drunkbatya/DrunkPCDebugger/README.md

# DrunkPC Debugger
A debugger and flasher for [DrunkPC](https://github.com/drunkbatya/DrunkPC)

<picture>
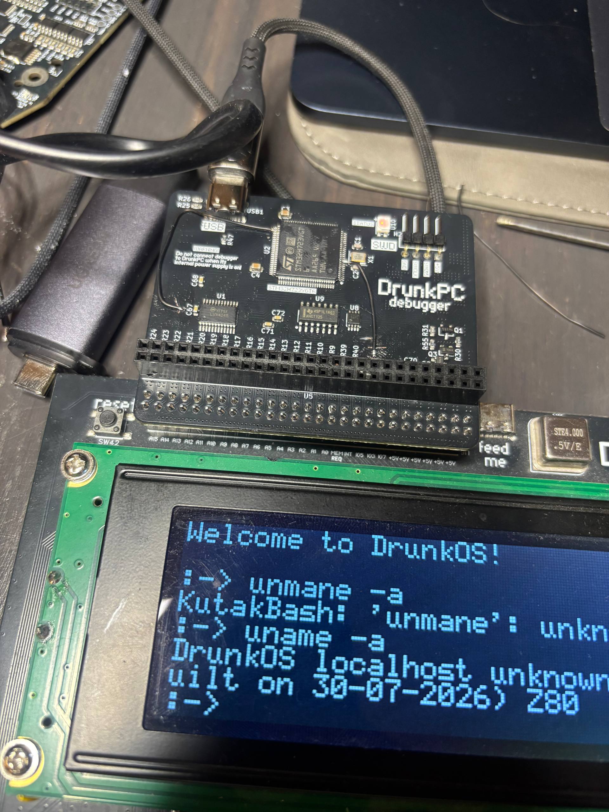
[picture p1: .github/assets/drunkpc_debugger_in_work.jpg]
    
</picture>

## How to use

## How to build firmware

## How to cli tool
