drunkbatya/DrunkPCDebugger/hardware/kicad/production/zip/bom.csv

Designator | Footprint | Quantity | Value | LCSC Part #
3V3_1 | TestPoint_Pad_D1.5mm | 1 | 3v3
5V_1 | TestPoint_Pad_D1.5mm | 1 | 5v
5V_BUS_1 | TestPoint_Pad_D1.5mm | 1 | 5vBus
C1, C2 | 0603 | 2 | CL10C180JB8NNNC | C1647
C3 | CP_EIA-3528-21_Kemet-B | 1 | 100uF 6.3V | C16133
C38 | EEFCX0J101R | 1 | EEFCX0J101R | C189619
C4 | 0805 | 1 | 10uF 25V | C15850
C43 | 0603 | 1 | CL10A475KO8NNNC | C19666
C5, C6 | 0603 | 2 | 2.2uF 16V | C23630
C59, C60, C61, C62, C63, C64, C65, C66, C67, C68, C69, C70, C71, C72, C73, C74, C75, C76 | 0603 | 18 | CC0603KRX7R9BB104 | C14663
C7 | 0603 | 1 | 2.2uF | C23630
D1 | USBLC6-2SC6_C2687116 | 1 | USBLC6-2SC6_C2687116 | C2687116
GND1 | TestPoint_Pad_2.0x2.0mm | 1 | GND
H1 | X6521WV-2_27H-C30D60 | 1 | X6521WV-2_27H-C30D60 | C725899
H2 | PZ254R-11-05P | 1 | PZ254R-11-05P | C492413
Q1, Q4 | AO3400A | 2 | AO3400A | C20917
Q2, Q3 | AO3401A | 2 | AO3401A | C15127
R1, R10, R11, R12, R13, R14, R15, R16, R17, R18, R19, R2, R20, R21, R22, R23, R24, R3, R36, R37, R38, R39, R4, R40, R41, R44, R5, R6, R7, R8, R9 | 0603 | 31 | 0603WAF1000T5E | C22775
R25, R26 | 0603 | 2 | 0603WAF5101T5E | C23186
R27, R28, R31, R32 | 0603 | 4 | 0603WAF1001T5E | C21190
R29, R30, R45, R46 | 0603 | 4 | 10kΩ | C25804
R33 | 0603 | 1 | 0603WAF1003T5E | C25803
R34, R35 | 0603 | 2 | 47kΩ | C25819
R42, R43, R47, R48, R49, R52, R53, R54, R55, R56, R57, R58 | 0603 | 12 | 0603WAF1002T5E | C25804
SW2, SW3 | TS3643TP | 2 | TS3643TP | C398054
U1, U3, U4, U7 | SN74LVC4245APWR | 4 | SN74LVC4245APWR | C7859
U10 | A-SC6302R6AGHC-A03-2T | 1 | A-SC6302R6AGHC-A03-2T | C5355456
U11 | SN74LVC3G07DCTR | 1 | SN74LVC3G07DCTR | C131914
U2 | STM32H723VET6 | 1 | STM32H723VET6 | C730141
U5 | X6521FV-2X27-C85D32 | 1 | X6521FV-2X27-C85D32 | C2884000
U6 | AMS1117-3_3 | 1 | AMS1117-3_3 | C6186
U8 | SN74LVC3G17DCTR | 1 | SN74LVC3G17DCTR | C18213
USB1 | TYPE-C_16PIN_2MD_073 | 1 | TYPE-C_16PIN_2MD_073 | C2765186
X1 | Crystal_SMD_3225-4Pin_3.2x2.5mm | 1 | X322525MOB4SI | C9006
