drunkbatya/DrunkPCDebugger/hardware/kicad/DrunkPCDebugger.kicad_pcb

## KiCad design hardware/kicad/DrunkPCDebugger.kicad_pcb (2026-10-22)

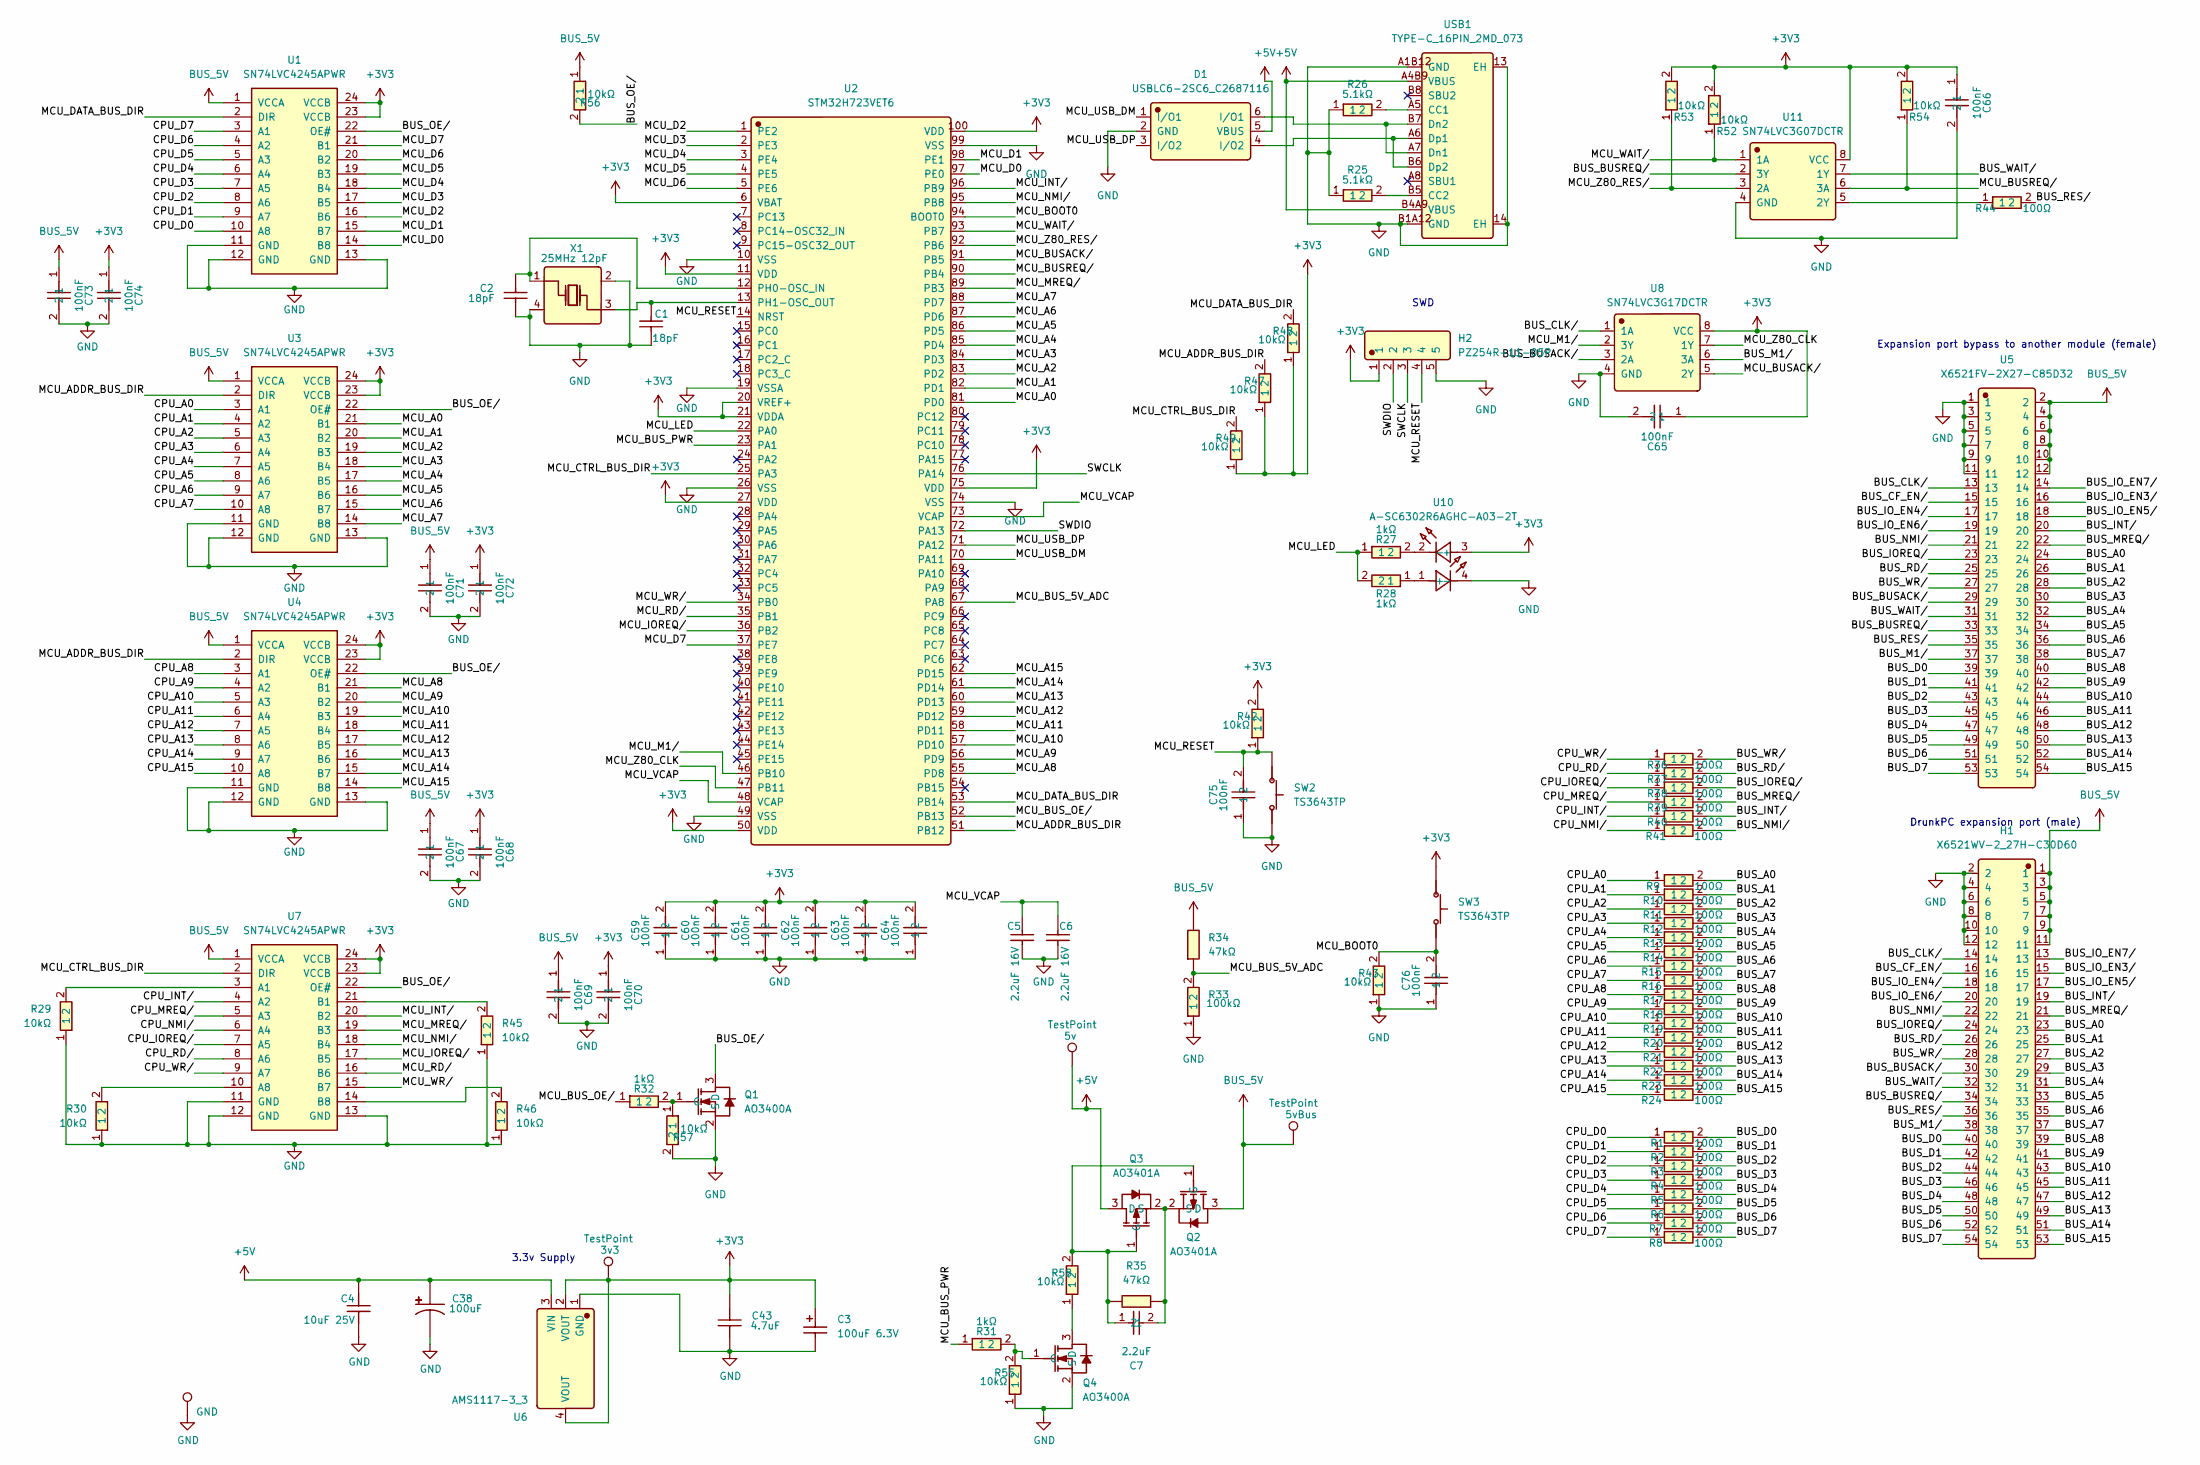
[picture p2: schematic DrunkPCDebugger.kicad_sch]

Parts:
3v3_1: 3v3; TestPoint_Pad_D1.5mm
5v_1: 5v; TestPoint_Pad_D1.5mm
5v_bus_1: 5vBus; TestPoint_Pad_D1.5mm
C1, C2: CL10C180JB8NNNC; C_0603_1608Metric; Manufacturer Part CL10C180JB8NNNC; LCSC C1647
C3: 100uF 6.3V; CP_EIA-3528-21_Kemet-B; Manufacturer Part TAJB107K006RNJ; LCSC C16133
C4: 10uF 25V; C_0805_2012Metric; Manufacturer Part CL21A106KAYNNNE; LCSC C15850
C5, C6: 2.2uF 16V; C_0603_1608Metric; Manufacturer Part CL10A225KO8NNNC; LCSC C23630
C7: 2.2uF; C_0603_1608Metric; Manufacturer Part CL10A225KO8NNNC; LCSC C23630
C38: EEFCX0J101R; Manufacturer Part EEFCX0J101R; LCSC C189619
C43: CL10A475KO8NNNC; C_0603_1608Metric; Manufacturer Part CL10A475KO8NNNC; LCSC C19666
C59, C60, C61, C62, C63, C64, C65, C66, C67, C68, C69, C70, C71, C72, C73, C74, C75, C76: CC0603KRX7R9BB104; C_0603_1608Metric; Manufacturer Part CC0603KRX7R9BB104; LCSC C14663
D1: USBLC6-2SC6_C2687116; Manufacturer Part USBLC6-2SC6; LCSC C2687116
GND1: GND; TestPoint_Pad_2.0x2.0mm
H1: X6521WV-2_27H-C30D60; Manufacturer Part X6521WV-2x27H-C60D30; LCSC C725899
H2: PZ254R-11-05P; Manufacturer Part PZ254R-11-05P; LCSC C492413
Q1, Q4: AO3400A; Manufacturer Part AO3400A; LCSC C20917
Q2, Q3: AO3401A; Manufacturer Part AO3401A; LCSC C15127
R1, R2, R3, R4, R5, R6, R7, R8, R9, R10, R11, R12, R13, R14, R15, R16, R17, R18, R19, R20, R21, R22, R23, R24, R36, R37, R38, R39, R40, R41, R44: 0603WAF1000T5E; R_0603_1608Metric; Manufacturer Part 0603WAF1000T5E; LCSC C22775
R25, R26: 0603WAF5101T5E; R_0603_1608Metric; Manufacturer Part 0603WAF5101T5E; LCSC C23186
R27, R28, R31, R32: 0603WAF1001T5E; R_0603_1608Metric; Manufacturer Part 0603WAF1001T5E; LCSC C21190
R29, R30, R45, R46: 10kΩ; R_0603_1608Metric; Manufacturer Part 0603WAF1002T5E; LCSC C25804
R33: 0603WAF1003T5E; R_0603_1608Metric; Manufacturer Part 0603WAF1003T5E; LCSC C25803
R34, R35: 47kΩ; R_0603_1608Metric; Manufacturer Part 0603WAF4702T5E; LCSC C25819
R42, R43, R47, R48, R49, R52, R53, R54, R55, R56, R57, R58: 0603WAF1002T5E; R_0603_1608Metric; Manufacturer Part 0603WAF1002T5E; LCSC C25804
SW2, SW3: TS3643TP; Manufacturer Part TS3643TP; LCSC C398054
U1, U3, U4, U7: SN74LVC4245APWR; Manufacturer Part SN74LVC4245APWR; LCSC C7859
U2: STM32H723VET6; Manufacturer Part STM32H723VET6; LCSC C730141
U5: X6521FV-2X27-C85D32; Manufacturer Part X6521FV-2x27-C85D32; LCSC C2884000
U6: AMS1117-3_3; Manufacturer Part AMS1117-3.3; LCSC C6186
U8: SN74LVC3G17DCTR; Manufacturer Part SN74LVC3G17DCTR; LCSC C18213
U10: A-SC6302R6AGHC-A03-2T; Manufacturer Part A-SC6302R6AGHC-A03-2T; LCSC C5355456
U11: SN74LVC3G07DCTR; Manufacturer Part SN74LVC3G07DCTR; LCSC C131914
USB1: TYPE-C_16PIN_2MD_073; Manufacturer Part TYPE-C 16PIN 2MD(073); LCSC C2765186
X1: X322525MOB4SI; Crystal_SMD_3225-4Pin_3.2x2.5mm; Manufacturer Part X322525MOB4SI; LCSC C9006

Connections:
+3V3: 3v3_1.1 (1_1), C3.1, C43.2, C59.2, C60.2, C61.2, C62.2, C63.2, C64.2, C65.1, C66.1, C68.1, C70.1, C72.1, C74.1, H2.1, R42.2, R47.1, R48.1, R49.1, R52.2, R53.2, R54.2, SW3.1, U1.23 (VCCB), U1.24 (VCCB), U2.6 (VBAT), U2.11 (VDD), U2.20 (VREF+), U2.21 (VDDA), U2.27 (VDD), U2.50 (VDD), U2.75 (VDD), U2.100 (VDD), U3.23 (VCCB), U3.24 (VCCB), U4.23 (VCCB), U4.24 (VCCB), U6.2 (VOUT), U6.4 (VOUT), U7.23 (VCCB), U7.24 (VCCB), U8.8 (VCC), U10.3 (+), U11.8 (VCC)
+5V: 5v_1.1 (1_1), C4.1, C38.1, D1.5 (VBUS), Q3.3 (D), U6.3 (VIN), USB1.A4B9 (VBUS), USB1.B4A9 (VBUS)
/BUS_A0: H1.23, R9.2, U5.24
/BUS_A1: H1.25, R10.2, U5.26
/BUS_A2: H1.27, R11.2, U5.28
/BUS_A3: H1.29, R12.2, U5.30
/BUS_A4: H1.31, R13.2, U5.32
/BUS_A5: H1.33, R14.2, U5.34
/BUS_A6: H1.35, R15.2, U5.36
/BUS_A7: H1.37, R16.2, U5.38
/BUS_A8: H1.39, R17.2, U5.40
/BUS_A9: H1.41, R18.2, U5.42
/BUS_A10: H1.43, R19.2, U5.44
/BUS_A11: H1.45, R20.2, U5.46
/BUS_A12: H1.47, R21.2, U5.48
/BUS_A13: H1.49, R22.2, U5.50
/BUS_A14: H1.51, R23.2, U5.52
/BUS_A15: H1.53, R24.2, U5.54
/BUS_BUSACK/: H1.30, U5.29, U8.3 (2A)
/BUS_BUSREQ/: H1.34, U5.33, U11.2 (3Y)
/BUS_CF_EN/: H1.16, U5.15
/BUS_CLK/: H1.14, U5.13, U8.1 (1A)
/BUS_D0: H1.40, R1.2, U5.39
/BUS_D1: H1.42, R2.2, U5.41
/BUS_D2: H1.44, R3.2, U5.43
/BUS_D3: H1.46, R4.2, U5.45
/BUS_D4: H1.48, R5.2, U5.47
/BUS_D5: H1.50, R6.2, U5.49
/BUS_D6: H1.52, R7.2, U5.51
/BUS_D7: H1.54, R8.2, U5.53
/BUS_INT/: H1.19, R40.2, U5.20
/BUS_IOREQ/: H1.24, R38.2, U5.23
/BUS_IO_EN3/: H1.15, U5.16
/BUS_IO_EN4/: H1.18, U5.17
/BUS_IO_EN5/: H1.17, U5.18
/BUS_IO_EN6/: H1.20, U5.19
/BUS_IO_EN7/: H1.13, U5.14
/BUS_M1/: H1.38, U5.37, U8.6 (3A)
/BUS_MREQ/: H1.21, R39.2, U5.22
/BUS_NMI/: H1.22, R41.2, U5.21
/BUS_OE/: Q1.3 (D), R56.2, U1.22 (OE#), U3.22 (OE#), U4.22 (OE#), U7.22 (OE#)
/BUS_RD/: H1.26, R37.2, U5.25
/BUS_RES/: H1.36, R44.2, U5.35
/BUS_WAIT/: H1.32, U5.31, U11.7 (1Y)
/BUS_WR/: H1.28, R36.2, U5.27
/CPU_A0: R9.1, U3.3 (A1)
/CPU_A1: R10.1, U3.4 (A2)
/CPU_A2: R11.1, U3.5 (A3)
/CPU_A3: R12.1, U3.6 (A4)
/CPU_A4: R13.1, U3.7 (A5)
/CPU_A5: R14.1, U3.8 (A6)
/CPU_A6: R15.1, U3.9 (A7)
/CPU_A7: R16.1, U3.10 (A8)
/CPU_A8: R17.1, U4.3 (A1)
/CPU_A9: R18.1, U4.4 (A2)
/CPU_A10: R19.1, U4.5 (A3)
/CPU_A11: R20.1, U4.6 (A4)
/CPU_A12: R21.1, U4.7 (A5)
/CPU_A13: R22.1, U4.8 (A6)
/CPU_A14: R23.1, U4.9 (A7)
/CPU_A15: R24.1, U4.10 (A8)
/CPU_D0: R1.1, U1.10 (A8)
/CPU_D1: R2.1, U1.9 (A7)
/CPU_D2: R3.1, U1.8 (A6)
/CPU_D3: R4.1, U1.7 (A5)
/CPU_D4: R5.1, U1.6 (A4)
/CPU_D5: R6.1, U1.5 (A3)
/CPU_D6: R7.1, U1.4 (A2)
/CPU_D7: R8.1, U1.3 (A1)
/CPU_INT/: R40.1, U7.4 (A2)
/CPU_IOREQ/: R38.1, U7.7 (A5)
/CPU_MREQ/: R39.1, U7.5 (A3)
/CPU_NMI/: R41.1, U7.6 (A4)
/CPU_RD/: R37.1, U7.8 (A6)
/CPU_WR/: R36.1, U7.9 (A7)
/MCU_A0: U2.81 (PD0), U3.21 (B1)
/MCU_A1: U2.82 (PD1), U3.20 (B2)
/MCU_A2: U2.83 (PD2), U3.19 (B3)
/MCU_A3: U2.84 (PD3), U3.18 (B4)
/MCU_A4: U2.85 (PD4), U3.17 (B5)
/MCU_A5: U2.86 (PD5), U3.16 (B6)
/MCU_A6: U2.87 (PD6), U3.15 (B7)
/MCU_A7: U2.88 (PD7), U3.14 (B8)
/MCU_A8: U2.55 (PD8), U4.21 (B1)
/MCU_A9: U2.56 (PD9), U4.20 (B2)
/MCU_A10: U2.57 (PD10), U4.19 (B3)
/MCU_A11: U2.58 (PD11), U4.18 (B4)
/MCU_A12: U2.59 (PD12), U4.17 (B5)
/MCU_A13: U2.60 (PD13), U4.16 (B6)
/MCU_A14: U2.61 (PD14), U4.15 (B7)
/MCU_A15: U2.62 (PD15), U4.14 (B8)
/MCU_ADDR_BUS_DIR: R47.2, U2.51 (PB12), U3.2 (DIR), U4.2 (DIR)
/MCU_BOOT0: C76.2, R43.2, SW3.2, U2.94 (BOOT0)
/MCU_BUSACK/: U2.91 (PB5), U8.5 (2Y)
/MCU_BUSREQ/: R54.1, U2.90 (PB4), U11.6 (3A)
/MCU_BUS_5V_ADC: R33.2, R34.1, U2.67 (PA8)
/MCU_BUS_OE/: R32.1, U2.52 (PB13)
/MCU_BUS_PWR: R31.1, U2.23 (PA1)
/MCU_CTRL_BUS_DIR: R49.2, U2.25 (PA3), U7.2 (DIR)
/MCU_D0: U1.14 (B8), U2.97 (PE0)
/MCU_D1: U1.15 (B7), U2.98 (PE1)
/MCU_D2: U1.16 (B6), U2.1 (PE2)
/MCU_D3: U1.17 (B5), U2.2 (PE3)
/MCU_D4: U1.18 (B4), U2.3 (PE4)
/MCU_D5: U1.19 (B3), U2.4 (PE5)
/MCU_D6: U1.20 (B2), U2.5 (PE6)
/MCU_D7: U1.21 (B1), U2.37 (PE7)
/MCU_DATA_BUS_DIR: R48.2, U1.2 (DIR), U2.53 (PB14)
/MCU_INT/: U2.96 (PB9), U7.20 (B2)
/MCU_IOREQ/: U2.36 (PB2), U7.17 (B5)
/MCU_LED: R27.1, R28.2, U2.22 (PA0)
/MCU_M1/: U2.46 (PB10), U8.2 (3Y)
/MCU_MREQ/: U2.89 (PB3), U7.19 (B3)
/MCU_NMI/: U2.95 (PB8), U7.18 (B4)
/MCU_RD/: U2.35 (PB1), U7.16 (B6)
/MCU_RESET: C75.2, H2.4, R42.1, SW2.1, U2.14 (NRST)
/MCU_USB_DM: D1.1 (I/O1), U2.70 (PA11)
/MCU_USB_DP: D1.3 (I/O2), U2.71 (PA12)
/MCU_VCAP: C5.1, C6.1, U2.48 (VCAP), U2.73 (VCAP)
/MCU_WAIT/: R52.1, U2.93 (PB7), U11.1 (1A)
/MCU_WR/: U2.34 (PB0), U7.15 (B7)
/MCU_Z80_CLK: U2.47 (PB11), U8.7 (1Y)
/MCU_Z80_RES/: R53.1, U2.92 (PB6), U11.3 (2A)
/SWCLK: H2.3, U2.76 (PA14)
/SWDIO: H2.2, U2.72 (PA13)
BUS_5V: 5v_bus_1.1 (1_1), C67.1, C69.1, C71.1, C73.1, H1.1, H1.3, H1.5, H1.7, H1.9, H1.11, Q2.3 (D), R34.2, R56.1, U1.1 (VCCA), U3.1 (VCCA), U4.1 (VCCA), U5.2, U5.4, U5.6, U5.8, U5.10, U5.12, U7.1 (VCCA)
GND: C1.2, C2.2, C3.2, C4.2, C5.2, C6.2, C38.2, C43.1, C59.1, C60.1, C61.1, C62.1, C63.1, C64.1, C65.2, C66.2, C67.2, C68.2, C69.2, C70.2, C71.2, C72.2, C73.2, C74.2, C75.1, C76.1, D1.2 (GND), GND1.1 (1_1), H1.2, H1.4, H1.6, H1.8, H1.10, H1.12, H2.5, Q1.2 (S), Q4.2 (S), R25.1, R26.1, R29.1, R30.1, R33.1, R43.1, R45.1, R46.1, R55.1, R57.2, SW2.2, U1.11 (GND), U1.12 (GND), U1.13 (GND), U2.10 (VSS), U2.19 (VSSA), U2.26 (VSS), U2.49 (VSS), U2.74 (VSS), U2.99 (VSS), U3.11 (GND), U3.12 (GND), U3.13 (GND), U4.11 (GND), U4.12 (GND), U4.13 (GND), U5.1, U5.3, U5.5, U5.7, U5.9, U5.11, U6.1 (GND), U7.11 (GND), U7.12 (GND), U7.13 (GND), U8.4 (GND), U10.4 (-), U11.4 (GND), USB1.13 (EH), USB1.14 (EH), USB1.A1B12 (GND), USB1.B1A12 (GND), X1.2 (GND), X1.4 (GND)
unnamed: Q1.1 (G), R32.2, R57.1
unnamed: C7.1, Q2.1 (G), Q3.1 (G), R35.2, R58.2
unnamed: C7.2, Q2.2 (S), Q3.2 (S), R35.1
unnamed: Q4.3 (D), R58.1
unnamed: Q4.1 (G), R31.2, R55.2
unnamed: R27.2, U10.2 (-)
unnamed: R28.1, U10.1 (+)
unnamed: C2.1, U2.12 (PH0-OSC_IN), X1.1 (OSC1)
unnamed: C1.1, U2.13 (PH1-OSC_OUT), X1.3 (OSC2)
unnamed: R29.2, U7.3 (A1)
unnamed: R30.2, U7.10 (A8)
unnamed: R45.2, U7.21 (B1)
unnamed: R46.2, U7.14 (B8)
unnamed: R44.1, U11.5 (2Y)
unnamed: R26.2, USB1.A5 (CC1)
unnamed: R25.2, USB1.B5 (CC2)
unnamed: D1.6 (I/O1), USB1.A7 (Dn1), USB1.B7 (Dn2)
unnamed: D1.4 (I/O2), USB1.A6 (Dp1), USB1.B6 (Dp2)

Notes on the sheet:
SWD
DrunkPC expansion port (male)
3.3v Supply
Expansion port bypass to another module (female)

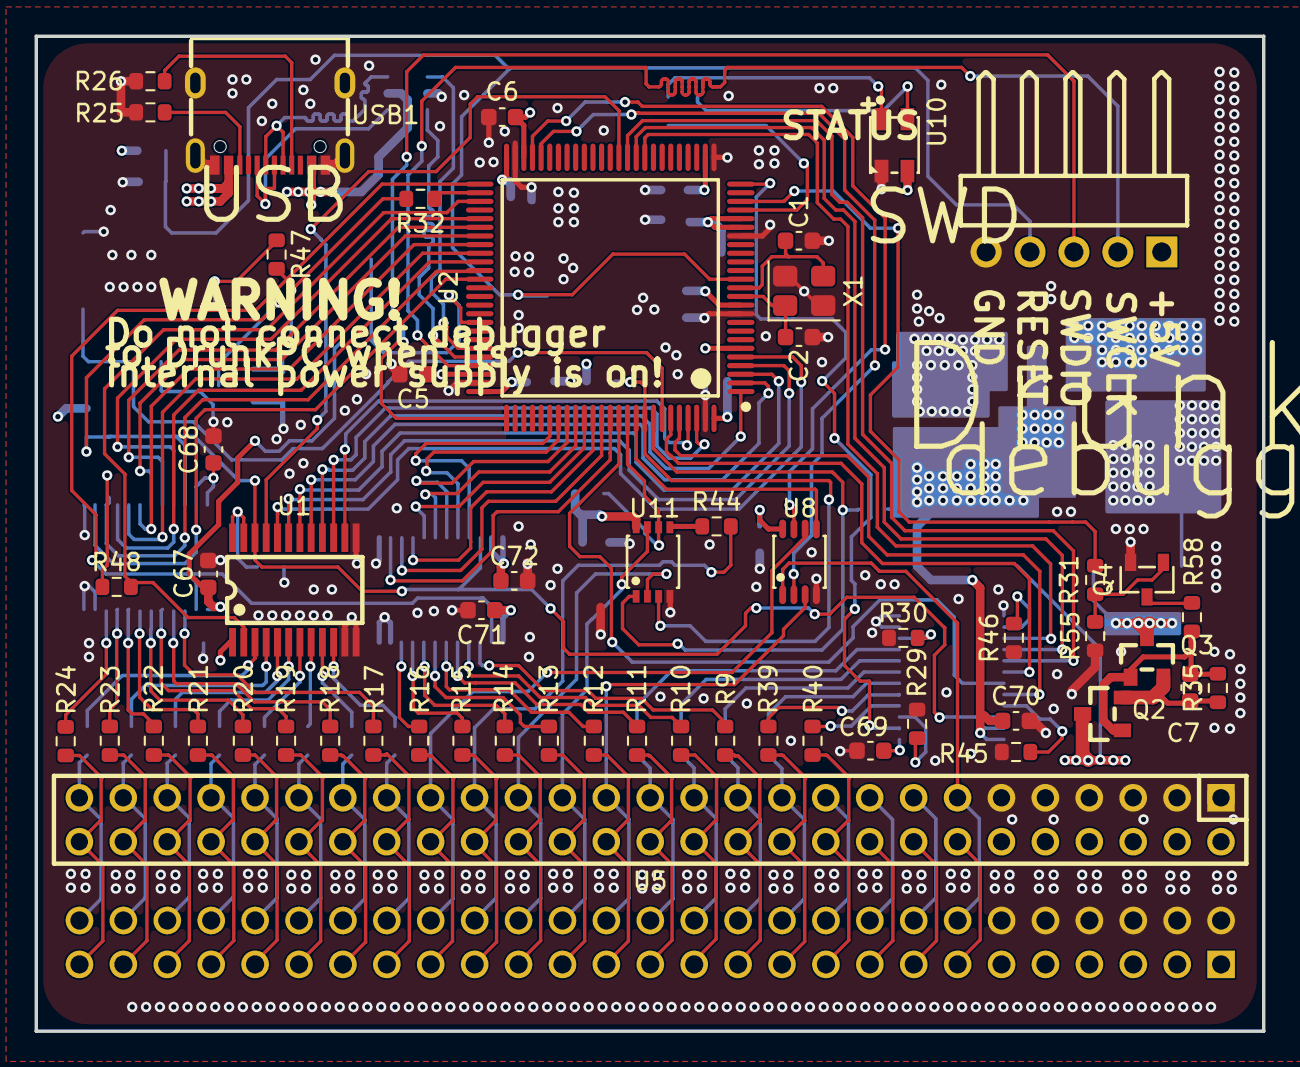
[picture p3: board DrunkPCDebugger.kicad_pcb from above]

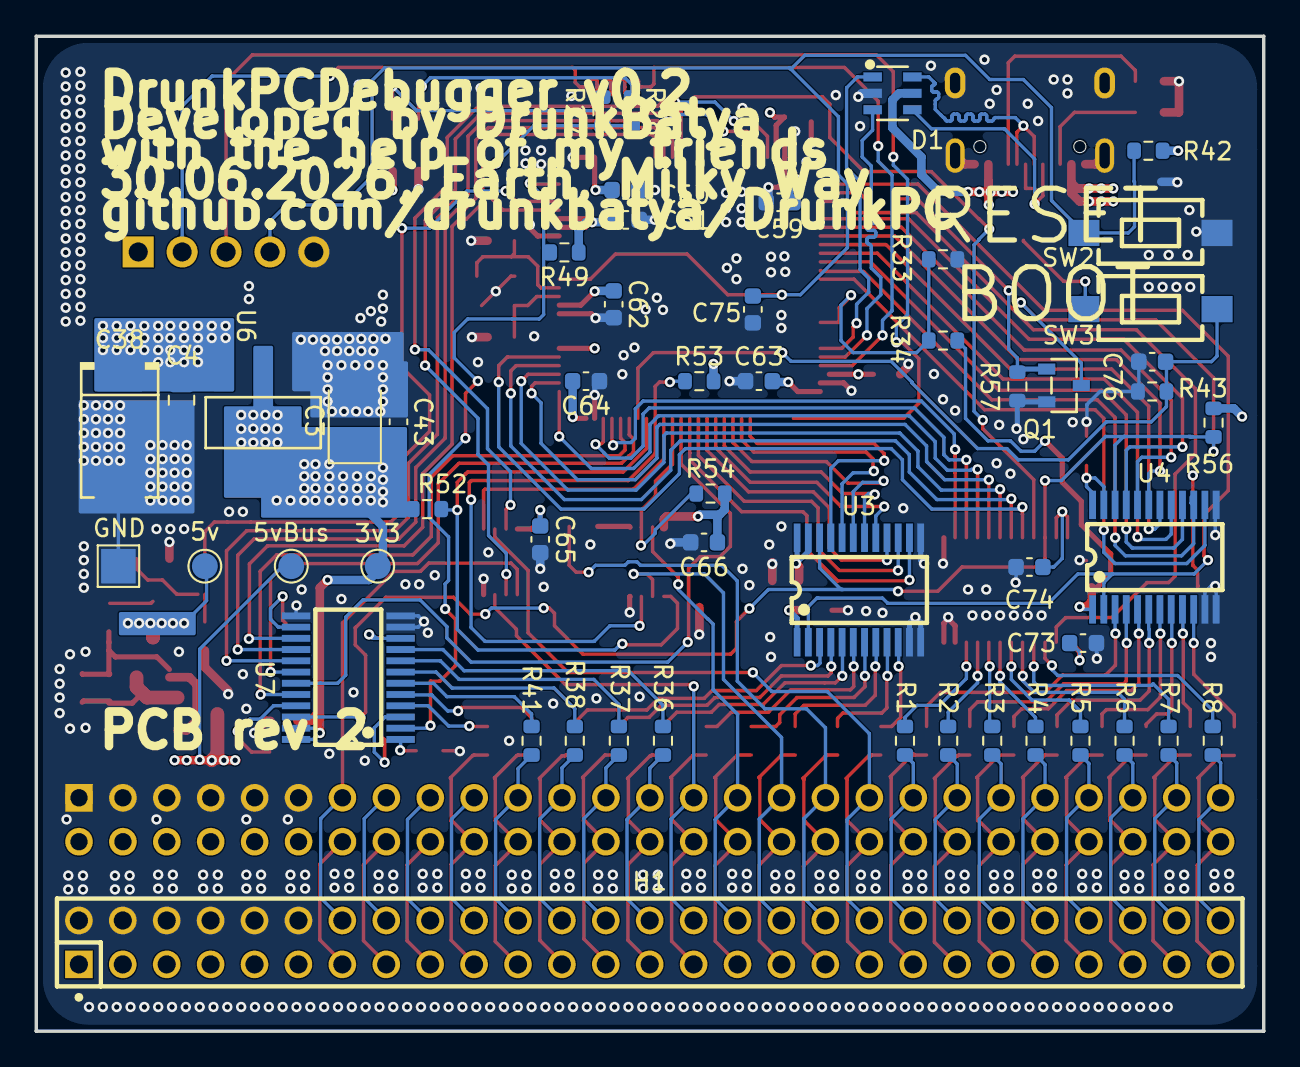
[picture p4: board DrunkPCDebugger.kicad_pcb from below]

Board: 4 copper layers, 71.0 x 57.5 mm, 108 parts (53 on the bottom side), 145 nets.
