drunkbatya/DrunkPCDebugger/software/src/targets/d1/stm/DrunkPCDebugger.ioc

Mcu.UserName=STM32H723VETx
PA0.GPIO_Label=LED
PA0.Signal=S_TIM5_CH1
PA1.GPIO_Label=BUS_PWR
PA1.Signal=GPIO_Output
PA11.Signal=USB_OTG_HS_DM
PA12.Signal=USB_OTG_HS_DP
PA13(JTMS/SWDIO).Signal=DEBUG_JTMS-SWDIO
PA14(JTCK/SWCLK).Signal=DEBUG_JTCK-SWCLK
PA3.GPIO_Label=CTRL_BUS_DIR
PA3.Signal=GPIO_Output
PA8.GPIO_Label=BUS_5V_SENSE
PA8.Signal=GPIO_Input
PB0.GPIO_Label=_WR
PB0.Signal=GPIO_Input
PB1.GPIO_Label=_RD
PB1.Signal=GPIO_Input
PB10.GPIO_Label=_M1
PB10.Signal=GPIO_Input
PB11.GPIO_Label=_CPU_CLK
PB11.Signal=S_TIM2_CH4
PB12.GPIO_Label=ADDR_BUS_DIR
PB12.Signal=GPIO_Output
PB13.GPIO_Label=BUS_OE
PB13.Signal=GPIO_Output
PB14.GPIO_Label=DATA_BUS_DIR
PB14.Signal=GPIO_Output
PB2.GPIO_Label=_IORQ
PB2.Signal=GPIO_Input
PB3(JTDO/TRACESWO).GPIO_Label=_MEMRQ
PB3(JTDO/TRACESWO).Signal=GPIO_Input
PB4(NJTRST).GPIO_Label=_BUSREQ
PB4(NJTRST).Signal=GPIO_Output
PB5.GPIO_Label=_BUSACK
PB5.Signal=GPIO_Input
PB6.GPIO_Label=_CPURST
PB6.Signal=GPIO_Output
PB7.GPIO_Label=_WAIT
PB7.Signal=GPIO_Output
PB8.GPIO_Label=_NMI
PB8.Signal=S_TIM16_CH1
PB9.GPIO_Label=_INT
PB9.Signal=S_TIM17_CH1
PD0.GPIO_Label=A0
PD0.Signal=GPIO_Input
PD1.GPIO_Label=A1
PD1.Signal=GPIO_Input
PD10.GPIO_Label=A10
PD10.Signal=GPIO_Input
PD11.GPIO_Label=A11
PD11.Signal=GPIO_Input
PD12.GPIO_Label=A12
PD12.Signal=GPIO_Input
PD13.GPIO_Label=A13
PD13.Signal=GPIO_Input
PD14.GPIO_Label=A14
PD14.Signal=GPIO_Input
PD15.GPIO_Label=A15
PD15.Signal=GPIO_Input
PD2.GPIO_Label=A2
PD2.Signal=GPIO_Input
PD3.GPIO_Label=A3
PD3.Signal=GPIO_Input
PD4.GPIO_Label=A4
PD4.Signal=GPIO_Input
PD5.GPIO_Label=A5
PD5.Signal=GPIO_Input
PD6.GPIO_Label=A6
PD6.Signal=GPIO_Input
PD7.GPIO_Label=A7
PD7.Signal=GPIO_Input
PD8.GPIO_Label=A8
PD8.Signal=GPIO_Input
PD9.GPIO_Label=A9
PD9.Signal=GPIO_Input
PE0.GPIO_Label=D0
PE0.Signal=GPIO_Input
PE1.GPIO_Label=D1
PE1.Signal=GPIO_Input
PE2.GPIO_Label=D2
PE2.Signal=GPIO_Input
PE3.GPIO_Label=D3
PE3.Signal=GPIO_Input
PE4.GPIO_Label=D4
PE4.Signal=GPIO_Input
PE5.GPIO_Label=D5
PE5.Signal=GPIO_Input
PE6.GPIO_Label=D6
PE6.Signal=GPIO_Input
PE7.GPIO_Label=D7
PE7.Signal=GPIO_Input
PH0-OSC_IN.Signal=RCC_OSC_IN
PH1-OSC_OUT.Signal=RCC_OSC_OUT
