drunkbatya/DrunkPCDebugger/software/src/targets/d1/stm/Core/Inc/main.h

#define D2_Pin LL_GPIO_PIN_2
#define D2_GPIO_Port GPIOE
#define D3_Pin LL_GPIO_PIN_3
#define D3_GPIO_Port GPIOE
#define D4_Pin LL_GPIO_PIN_4
#define D4_GPIO_Port GPIOE
#define D5_Pin LL_GPIO_PIN_5
#define D5_GPIO_Port GPIOE
#define D6_Pin LL_GPIO_PIN_6
#define D6_GPIO_Port GPIOE
#define LED_Pin LL_GPIO_PIN_0
#define LED_GPIO_Port GPIOA
#define BUS_PWR_Pin LL_GPIO_PIN_1
#define BUS_PWR_GPIO_Port GPIOA
#define CTRL_BUS_DIR_Pin LL_GPIO_PIN_3
#define CTRL_BUS_DIR_GPIO_Port GPIOA
#define _WR_Pin LL_GPIO_PIN_0
#define _WR_GPIO_Port GPIOB
#define _RD_Pin LL_GPIO_PIN_1
#define _RD_GPIO_Port GPIOB
#define _IORQ_Pin LL_GPIO_PIN_2
#define _IORQ_GPIO_Port GPIOB
#define D7_Pin LL_GPIO_PIN_7
#define D7_GPIO_Port GPIOE
#define _M1_Pin LL_GPIO_PIN_10
#define _M1_GPIO_Port GPIOB
#define _CPU_CLK_Pin LL_GPIO_PIN_11
#define _CPU_CLK_GPIO_Port GPIOB
#define ADDR_BUS_DIR_Pin LL_GPIO_PIN_12
#define ADDR_BUS_DIR_GPIO_Port GPIOB
#define BUS_OE_Pin LL_GPIO_PIN_13
#define BUS_OE_GPIO_Port GPIOB
#define DATA_BUS_DIR_Pin LL_GPIO_PIN_14
#define DATA_BUS_DIR_GPIO_Port GPIOB
#define A8_Pin LL_GPIO_PIN_8
#define A8_GPIO_Port GPIOD
#define A9_Pin LL_GPIO_PIN_9
#define A9_GPIO_Port GPIOD
#define A10_Pin LL_GPIO_PIN_10
#define A10_GPIO_Port GPIOD
#define A11_Pin LL_GPIO_PIN_11
#define A11_GPIO_Port GPIOD
#define A12_Pin LL_GPIO_PIN_12
#define A12_GPIO_Port GPIOD
#define A13_Pin LL_GPIO_PIN_13
#define A13_GPIO_Port GPIOD
#define A14_Pin LL_GPIO_PIN_14
#define A14_GPIO_Port GPIOD
#define A15_Pin LL_GPIO_PIN_15
#define A15_GPIO_Port GPIOD
#define BUS_5V_SENSE_Pin LL_GPIO_PIN_8
#define BUS_5V_SENSE_GPIO_Port GPIOA
#define A0_Pin LL_GPIO_PIN_0
#define A0_GPIO_Port GPIOD
#define A1_Pin LL_GPIO_PIN_1
#define A1_GPIO_Port GPIOD
#define A2_Pin LL_GPIO_PIN_2
#define A2_GPIO_Port GPIOD
#define A3_Pin LL_GPIO_PIN_3
#define A3_GPIO_Port GPIOD
#define A4_Pin LL_GPIO_PIN_4
#define A4_GPIO_Port GPIOD
#define A5_Pin LL_GPIO_PIN_5
#define A5_GPIO_Port GPIOD
#define A6_Pin LL_GPIO_PIN_6
#define A6_GPIO_Port GPIOD
#define A7_Pin LL_GPIO_PIN_7
#define A7_GPIO_Port GPIOD
#define _MEMRQ_Pin LL_GPIO_PIN_3
#define _MEMRQ_GPIO_Port GPIOB
#define _BUSREQ_Pin LL_GPIO_PIN_4
#define _BUSREQ_GPIO_Port GPIOB
#define _BUSACK_Pin LL_GPIO_PIN_5
#define _BUSACK_GPIO_Port GPIOB
#define _CPURST_Pin LL_GPIO_PIN_6
#define _CPURST_GPIO_Port GPIOB
#define _WAIT_Pin LL_GPIO_PIN_7
#define _WAIT_GPIO_Port GPIOB
#define _NMI_Pin LL_GPIO_PIN_8
#define _NMI_GPIO_Port GPIOB
#define _INT_Pin LL_GPIO_PIN_9
#define _INT_GPIO_Port GPIOB
#define D0_Pin LL_GPIO_PIN_0
#define D0_GPIO_Port GPIOE
#define D1_Pin LL_GPIO_PIN_1
#define D1_GPIO_Port GPIOE
