drunkbatya/DrunkPCDebugger/software/src/bus/power.h

#pragma once

#include <stdbool.h>

#ifdef __cplusplus
extern "C" {
#endif

void bus_power_set_enabled(bool enabled);

bool bus_power_is_enabled(void);

bool bus_power_is_present(void);

bool bus_power_turn_on(void);

#ifdef __cplusplus
}
#endif
