drunkbatya/DrunkPCDebugger/(commit log)

2026-06-30 Fix silk
    [DrunkPCDebugger.kicad_pcb]
2026-07-14 stm, fix
    [DrunkPCDebugger.kicad_pcb, DrunkPCDebugger.kicad_sch, bom.csv, designators.csv, positions.csv]
2026-07-23 Add device tests, subargs, more rpc
2026-07-26 Add anoter rev, interrupt, delay
    [DrunkPCDebugger.kicad_pcb, DrunkPCDebugger.kicad_sch, bom.csv, designators.csv, positions.csv]
2026-07-26 Fix errata in rev2
    [DrunkPCDebugger.kicad_pcb, DrunkPCDebugger.kicad_sch, bom.csv, designators.csv, positions.csv]
2026-07-26 Add at28c256 fuctions, clang-format, usb uart
2026-07-27 Fix proto, renames, add resources
    [gpio.c, gpio.h, resources.c, resources.h]
2026-07-27 Add rev2 fab
    [DrunkPCDebugger.kicad_pcb, bom.csv, designators.csv, positions.csv]
2026-07-27 Change protobuf, fix cube pulls
    [DrunkPCDebugger.ioc, gpio.c]
2026-07-29 Add bus power
2026-08-05 Add crash handler, fix usb string
    [delay.c, gpio.c, interrupt.c, kal.c, rpc.c]
2026-08-10 Fix device usb string
2026-10-22 Fix firmware for new pcb rev
2026-10-22 Pcb production
